AdrianEthan/STM32-BUCK/HARDWARE/DHT11/dht11.h

#ifndef __DHT11_H
#define __DHT11_H 
#include "sys.h"   
//IO方向设置
#define DHT11_IO_IN()  {GPIOA->CRH&=0XFFFF0FFF;GPIOA->CRH|=8<<12;}
#define DHT11_IO_OUT() {GPIOA->CRH&=0XFFFF0FFF;GPIOA->CRH|=3<<12;}
////IO操作函数											   
#define	DHT11_DQ_OUT PAout(11) //数据端口	PA11
#define	DHT11_DQ_IN  PAin(11)  //数据端口	PA11

u8 DHT11_Init(void);//初始化DHT11
u8 DHT11_Read_Data(u8 *temp,u8 *humi);//读取温湿度
u8 DHT11_Read_Byte(void);//读出一个字节
u8 DHT11_Read_Bit(void);//读出一个位
u8 DHT11_Check(void);//检测是否存在DHT11
void DHT11_Rst(void);//复位DHT11    
#endif
