AdrianEthan/STM32-BUCK/USER/main.h

/*-----------------------------------------------------*/
/*              超纬电子STM32系列开发板                */
/*-----------------------------------------------------*/
/*                     程序结构                        */
/*-----------------------------------------------------*/
/*USER     ：包含程序的main函数，是整个程序的入口      */
/*HARDWARE ：包含开发板各种功能外设的驱动程序          */
/*CORE     ：包含STM32的核心程序，官方提供，我们不修改 */
/*STLIB    ：官方提供的库文件，我们不修改              */
/*-----------------------------------------------------*/
/*                                                     */
/*           程序main函数，入口函数头文件              */
/*                                                     */
/*-----------------------------------------------------*/

#ifndef __MAIN_H
#define __MAIN_H
#include "sys.h"
extern u8 pid_mode;//=0不工作，=1工作
extern u16 buck_pwm;//BOOST电路的PWM
extern float DC_V;//电压数据
extern float DC_I;//电流数据
extern float Target_V;//追踪的电压数据

extern u8 protect_status;//保护状态
extern u8 sw_status;//开关状态
#define V_xishu 9.9786
#define I_xishu 1.04

#endif
