AdrianEthan/STM32-BUCK/(commit log)

2026-10-12 修改readme文件
2026-10-12 docs: 添加开源复刻声明
2026-10-12 修改内容
